zarte13/PI4/integration_elec/FOOTPRINTS/README.txt

Dossier pour mettre les footprints des pièces
