zarte13/PI4/integration_elec/SYMBOLS/README.txt

Dossier pour mettre les symboles des pièces spéciales
