zarte13/PI4/integration_elec/3D_PARTS/README.txt

Dossier pour mettre les modèles de pièces en 3D
