zarte13/PI4/integration_elec/3D_PARTS/SMA_DIO.step

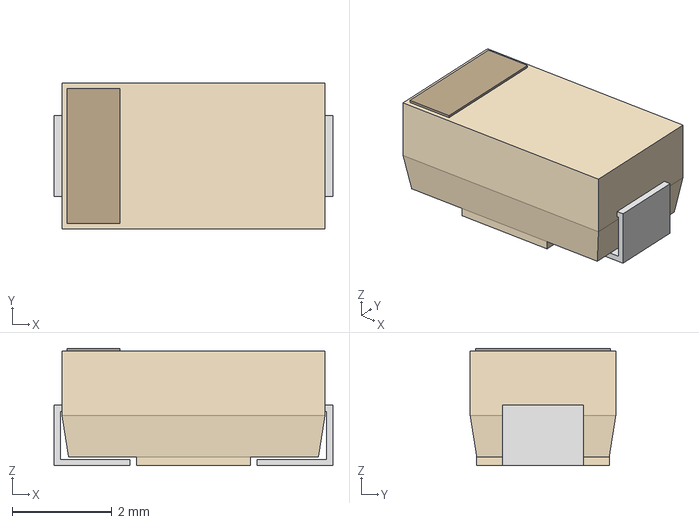
[picture p1: CAD file, 2026-02-20]
integration_elec/3D_PARTS/SMA_DIO.step
5.59 x 2.92 x 2.35 mm
