zarte13/PI4/integration_elec/3D_PARTS/RELAY8_J104D2C12VDC_20S_CRS.step

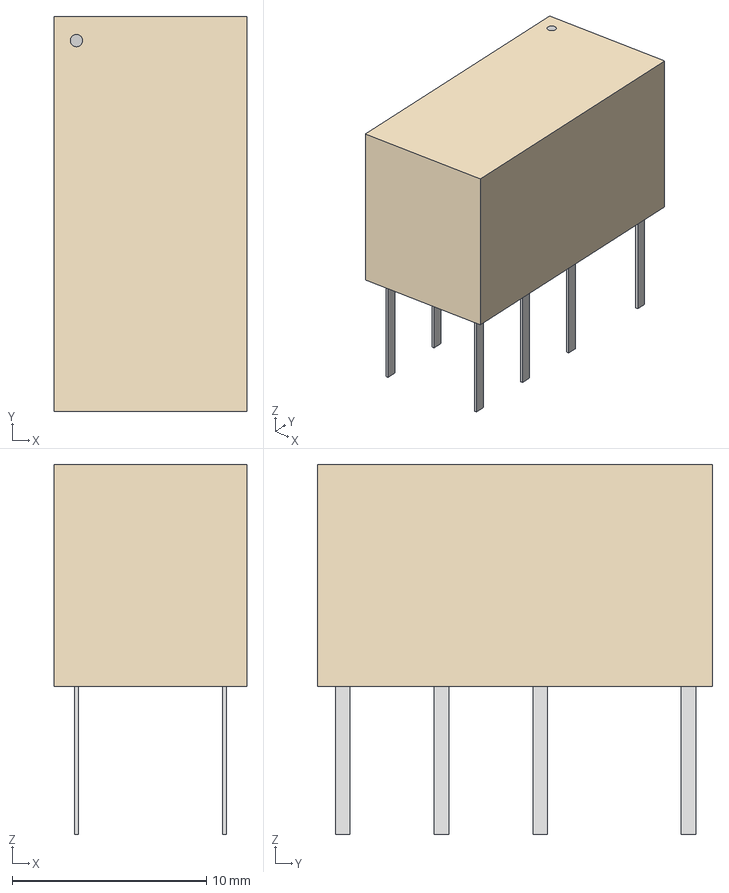
[picture p2: CAD file, 2026-02-20]
integration_elec/3D_PARTS/RELAY8_J104D2C12VDC_20S_CRS.step
9.91 x 20.3 x 19.1 mm
