zarte13/PI4/integration_elec/3D_PARTS/MICROFIT/436500315.stp

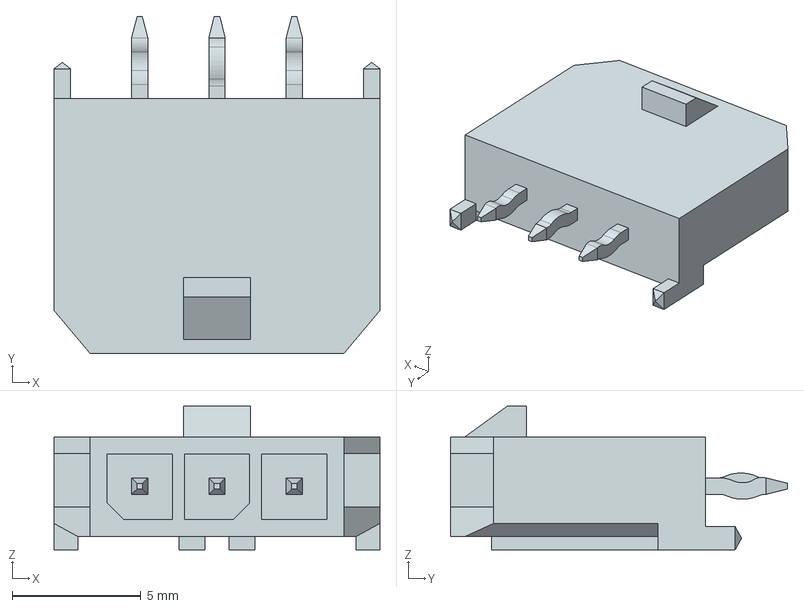
[picture p4: CAD file, 2026-03-10]
integration_elec/3D_PARTS/MICROFIT/436500315.stp
12.7 x 13.1 x 5.57 mm
