zarte13/PI4/(threads)

Thread 3 (2025-09-19):

Matrice decisionelle

zarte13, 2025-09-19:
Cette matrice permet de decider quelle sous-solution on choisit du type : pompe embarquee sur le drone, pompe au sol, deplacement d'air du type air comprimer paintball .....

Closed 2025-10-03.

Thread 11 (2025-09-21):

Analyse produit chimique préliminaire

zarte13, 2025-09-21:

zarte13, 2025-09-30:
**Funmilayo:**
- Recherche type de glace
- Contrainte environnementale des produits chimique (anti-givre)
- Corrosivité des produits
**Dominic:**
- Contrainte environnementale des produits chimiques (dégivrant)
-recherche composition structurelle éoliennes
-recherche solutions anti-givre (coatings)
-trouver le responsable des labos de projet indiv. de génie chimique et entrer en contact avec lui pour stocker montage expérimental
-envoyer fiches techniques produits chim. à Gino

Closed 2025-10-03.
