zarte13/PI4/integration_elec/integration_elec_slave/integration_elec_slave.kicad_pcb

## KiCad design integration_elec/integration_elec_slave/integration_elec_slave.kicad_pcb (2026-03-04)

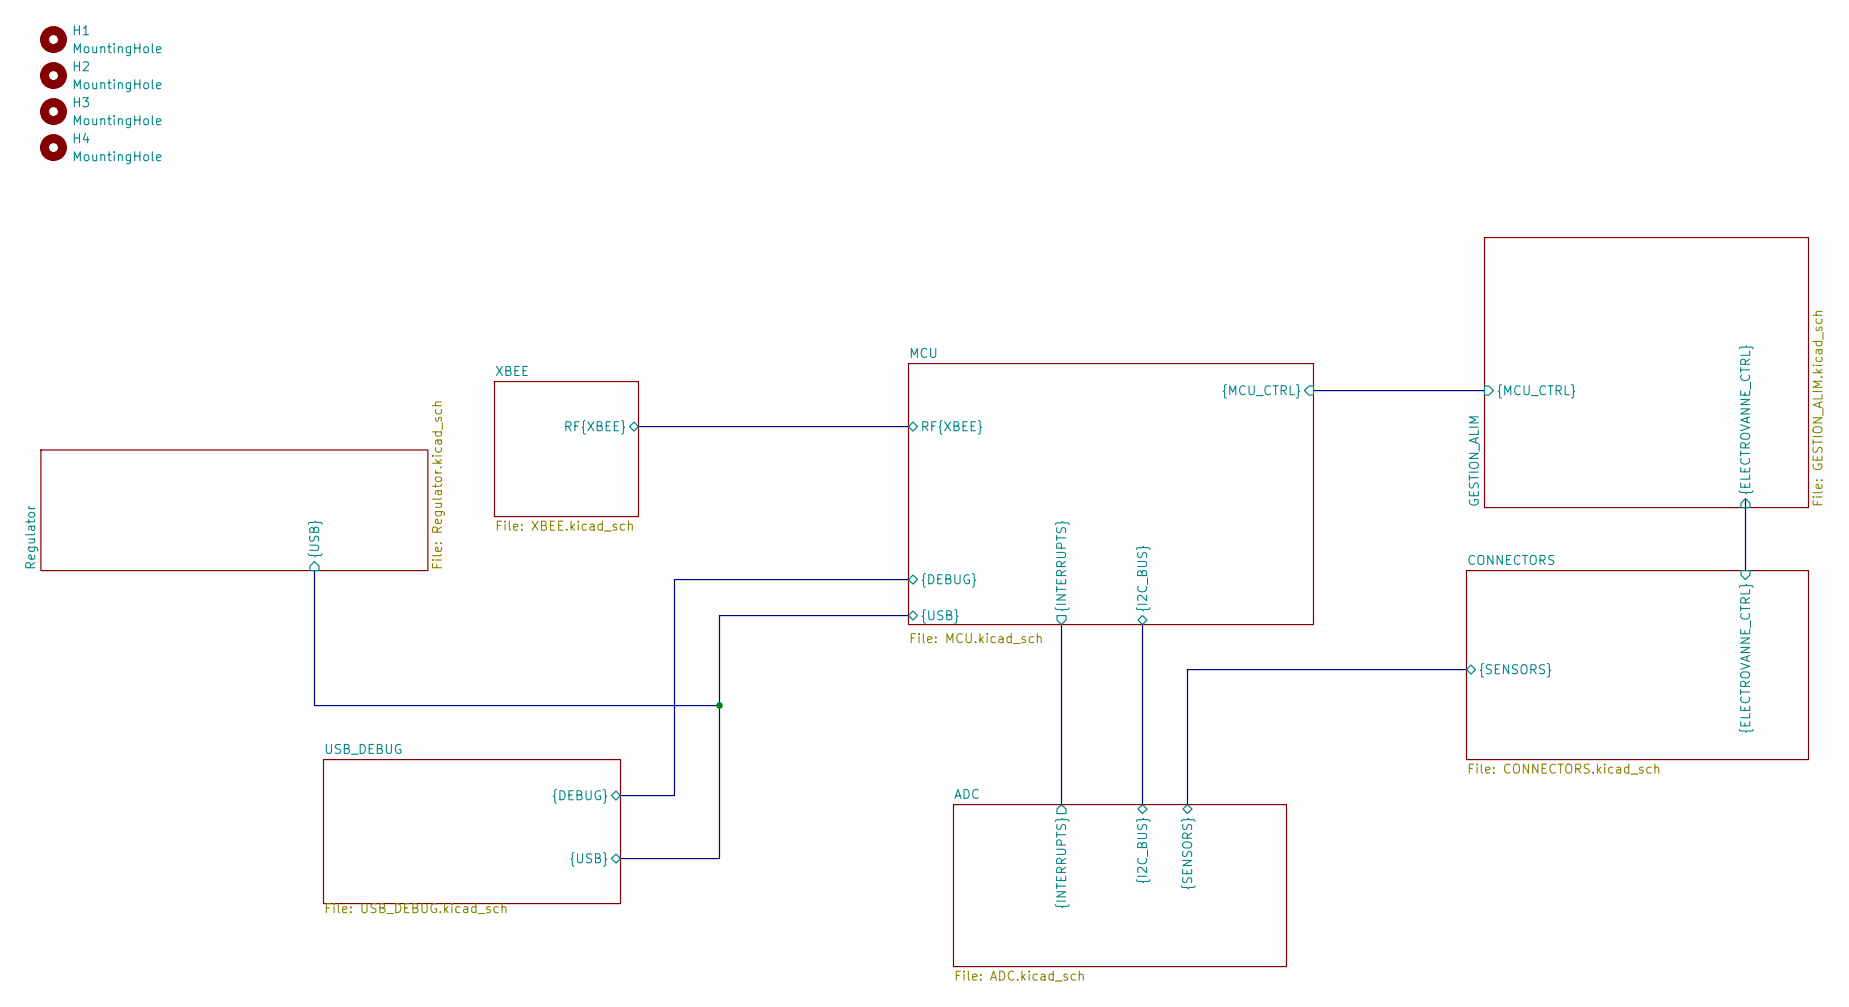
[picture p5: schematic integration_elec_slave.kicad_sch]

Parts:
H1, H2, H3, H4: MountingHole; MountingHole_3.2mm_M3

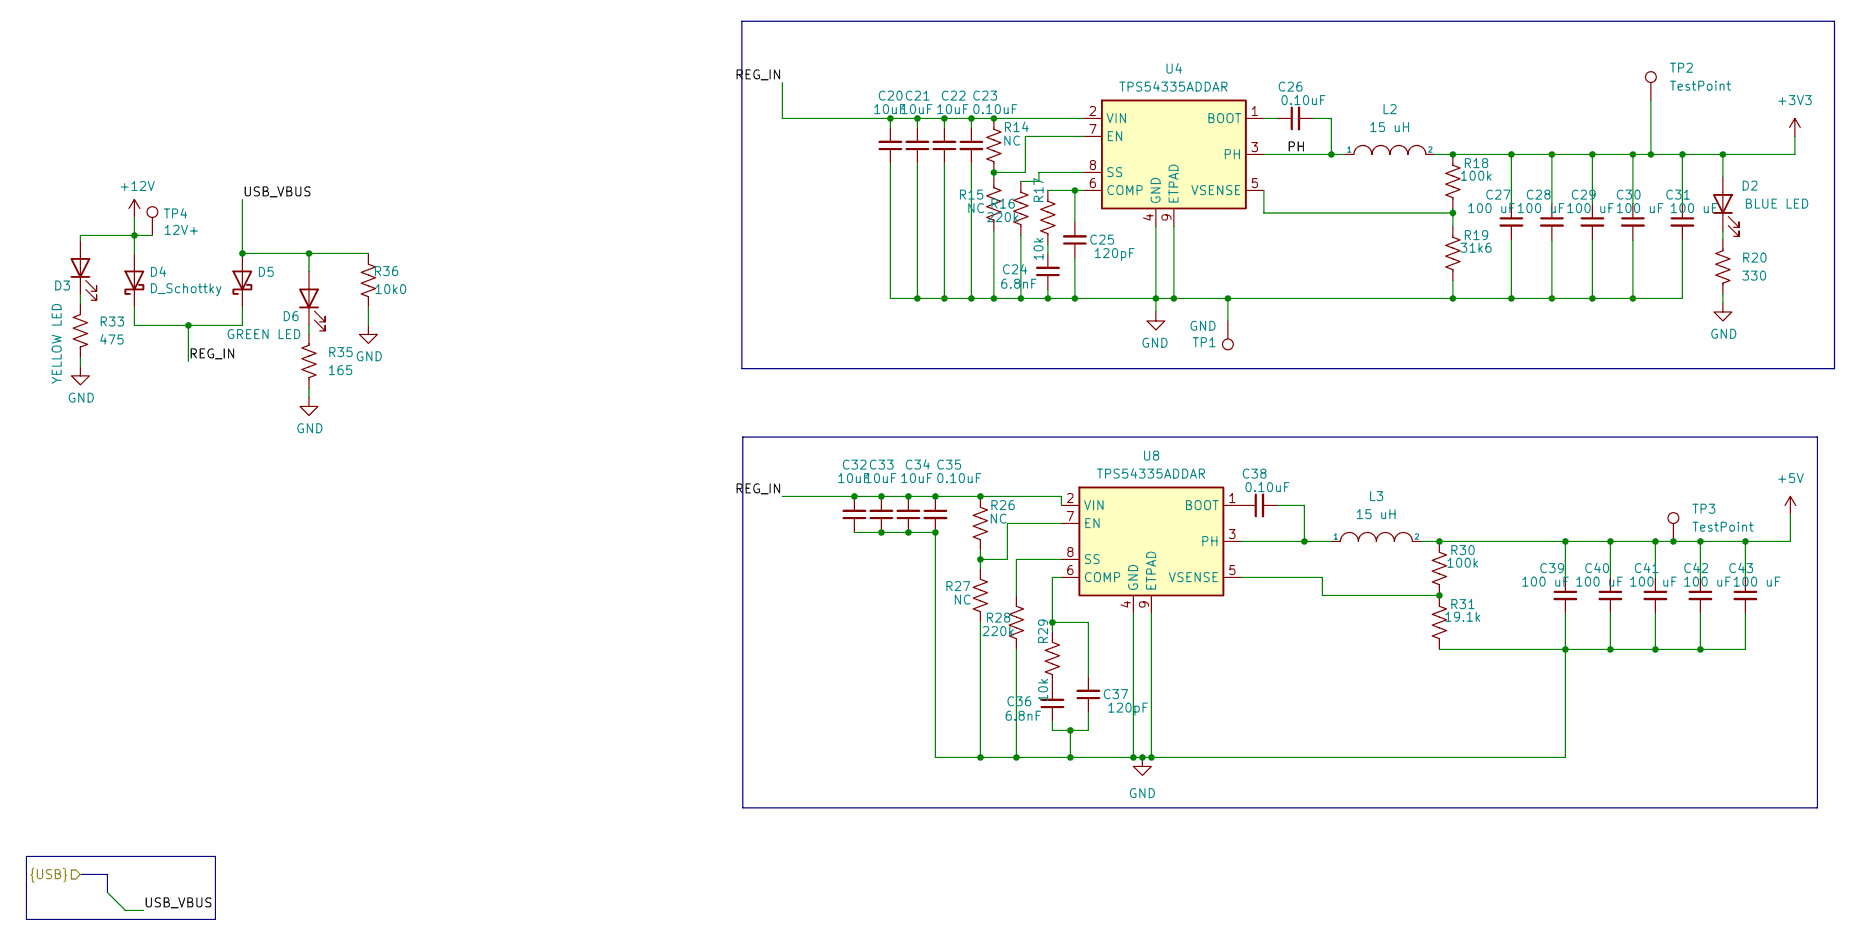
[picture p6: schematic Regulator.kicad_sch]

Parts:
C20, C21, C22, C32, C33, C34: 10uF; C_0805_2012Metric_Pad1.18x1.45mm_HandSolder; Manufacturer Part Number CL21A106KOQNNNE; DigiKey 1276-1096-1-ND
C23, C26, C35, C38: 0.10uF; C_0805_2012Metric_Pad1.18x1.45mm_HandSolder; Manufacturer Part Number CL21B104KBCNNNC; DigiKey 1276-1003-2-ND
C24, C36: 6.8nF; C_0805_2012Metric_Pad1.18x1.45mm_HandSolder; Manufacturer Part Number C0805C682K5RAC7800; DigiKey 399-C0805C682K5RAC7800TR-ND
C25, C37: 120pF; C_0805_2012Metric_Pad1.18x1.45mm_HandSolder; Manufacturer Part Number C0805C121J5GAC7800; DigiKey 399-C0805C121J5GAC7800TR-ND
C27, C28, C29, C30, C31, C39, C40, C41, C42, C43: 100 uF; C_1206_3216Metric; Manufacturer Part Number GRM31CR61A107MEA8L; DigiKey 490-GRM31CR61A107MEA8LTR-ND
D2: BLUE LED; LED_0805_2012Metric_Pad1.15x1.40mm_HandSolder; Manufacturer Part Number 5973605607F; DigiKey 350-4394-1-ND
D3: YELLOW LED; LED_1206_3216Metric; Manufacturer Part Number QTLP650D3TR; DigiKey 1080-1418-2-ND
D4, D5: D_Schottky; SOD323-HE; Manufacturer Part Number MBR1060HEWS_R1_00001; DigiKey 3757-MBR1060HEWS_R1_00001CT-ND
D6: GREEN LED; LED_1206_3216Metric; Manufacturer Part Number 5973605607F; DigiKey 350-4394-1-ND
L2, L3: 15 uH; IND_BOURNS_SRR1280; Manufacturer Part Number SRR1280-150M; DigiKey SRR1280-150MTR-ND
R14, R15, R26, R27: NC; R_0805_2012Metric_Pad1.20x1.40mm_HandSolder
R16, R28: 220k; R_0805_2012Metric_Pad1.20x1.40mm_HandSolder; Manufacturer Part Number CRG0805F220K; DigiKey A126350CT-ND
R17, R29: 10k; R_0805_2012Metric_Pad1.20x1.40mm_HandSolder; Manufacturer Part Number RC0805FR-0710KL; DigiKey 311-10.0KCRCT-ND
R18, R30: 100k; R_0805_2012Metric_Pad1.20x1.40mm_HandSolder; Manufacturer Part Number RC0805FR-07100KL; DigiKey 311-100KCRTR-ND
R19: 31k6; R_0805_2012Metric_Pad1.20x1.40mm_HandSolder; Manufacturer Part Number RC0805FR-0731K6L; DigiKey 311-31.6KCRTR-ND
R20: 330; R_0805_2012Metric_Pad1.20x1.40mm_HandSolder; Manufacturer Part Number RC0805JR-07330RL; DigiKey 311-330ARCT-ND
R31: 19.1k; R_0805_2012Metric_Pad1.20x1.40mm_HandSolder; DigiKey 311-19.1KCRCT-ND
R33: 475; R_0805_2012Metric_Pad1.20x1.40mm_HandSolder; Manufacturer Part Number RNCP0805FTD475R; DigiKey RNCP0805FTD475RTR-ND
R35: 165; R_0805_2012Metric_Pad1.20x1.40mm_HandSolder; Manufacturer Part Number RC0805FR-07165RL; DigiKey 311-165CRTR-ND
R36: 10k0; R_0603_1608Metric_Pad0.98x0.95mm_HandSolder; Manufacturer Part Number RC0805FR-0710KL; DigiKey 311-10.0KHRCT-ND
TP1: GND; TestPoint_Plated_Hole_D2.0mm
TP2, TP3: TestPoint; TestPoint_Plated_Hole_D2.0mm
TP4: 12V+; TestPoint_Plated_Hole_D2.0mm
U4, U8: TPS54335ADDAR; TI_SO-PowerPAD-8_ThermalVias; Manufacturer Part Number TPS54335ADDAR; DigiKey 296-TPS54335ADDARTR-ND

Connections:
+3V3: C27.1, C28.1, C29.1, C30.1, C31.1, D2.2 (A), L2.2, R18.1, TP2.1; also elsewhere on the board
+5V: C39.1, C40.1, C41.1, C42.1, C43.1, L3.2, R30.1, TP3.1; also elsewhere on the board
+12V: D3.2 (A), D4.2 (A), TP4.1; also elsewhere on the board
/MCU/USB_VBUS: D5.2 (A), D6.2 (A), R36.1; also elsewhere on the board
/Regulator/PH: C26.2, L2.1, U4.3 (PH)
/Regulator/REG_IN: C20.2, C21.2, C22.2, C23.1, C32.2, C33.2, C34.2, C35.1, D4.1 (K), D5.1 (K), R14.1, R26.1, U4.2 (VIN), U8.2 (VIN)
GND: C20.1, C21.1, C22.1, C23.2, C24.1, C25.1, C27.2, C28.2, C29.2, C30.2, C31.2, C32.1, C33.1, C34.1, C35.2, C36.1, C37.1, C39.2, C40.2, C41.2, C42.2, C43.2, R15.2, R16.2, R19.2, R20.2, R27.2, R28.2, R31.2, R33.2, R35.2, R36.2, TP1.1, U4.4 (GND), U4.9 (ETPAD), U8.4 (GND), U8.9 (ETPAD); also elsewhere on the board
unnamed: C24.2, R17.2
unnamed: C36.2, R29.2
unnamed: D2.1 (K), R20.1
unnamed: D3.1 (K), R33.1
unnamed: D6.1 (K), R35.1
unnamed: C26.1, U4.1 (BOOT)
unnamed: C25.2, R17.1, U4.6 (COMP)
unnamed: R14.2, R15.1, U4.7 (EN)
unnamed: R16.1, U4.8 (SS)
unnamed: R18.2, R19.1, U4.5 (VSENSE)
unnamed: C38.1, U8.1 (BOOT)
unnamed: C37.2, R29.1, U8.6 (COMP)
unnamed: R26.2, R27.1, U8.7 (EN)
unnamed: C38.2, L3.1, U8.3 (PH)
unnamed: R28.1, U8.8 (SS)
unnamed: R30.2, R31.1, U8.5 (VSENSE)

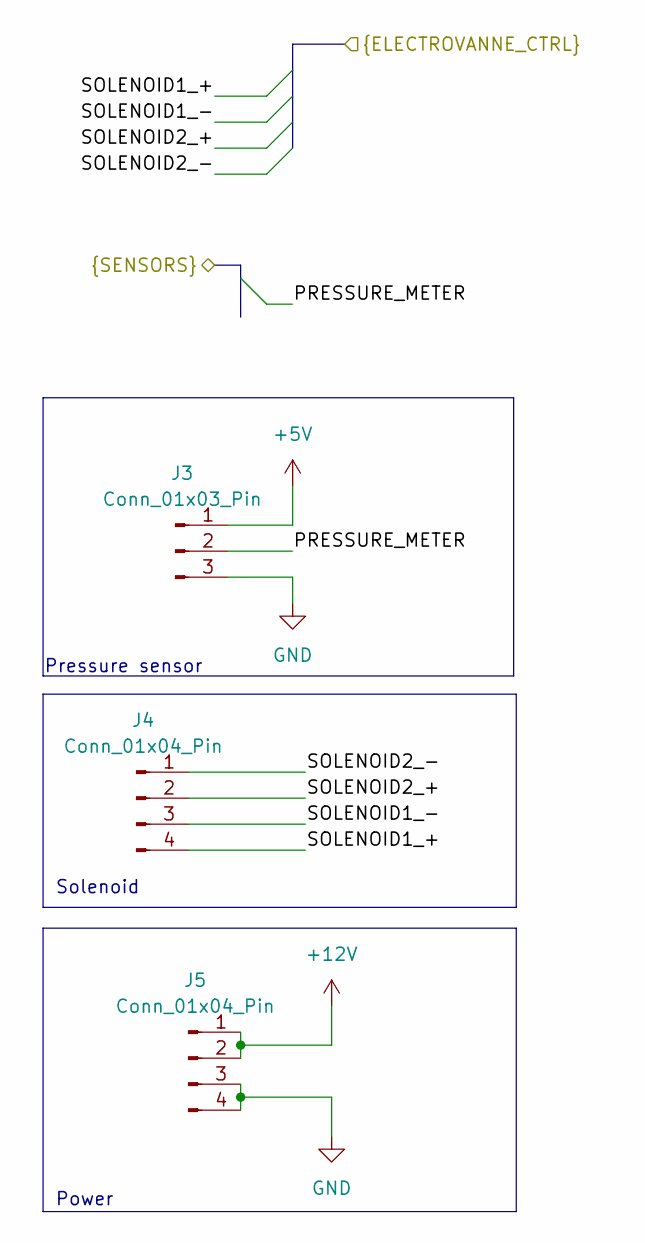
[picture p7: schematic CONNECTORS.kicad_sch]

Parts:
J3: Conn_01x03_Pin; Molex_Micro-Fit_3.0_43650-0315_1x03_P3.00mm_Vertical; DigiKey 538-43650-0315
J4, J5: Conn_01x04_Pin; Molex_Micro-Fit_3.0_43650-0415_1x04_P3.00mm_Vertical; DigiKey WM1919-ND

Connections:
+5V: J3.1; also elsewhere on the board
+12V: J5.1, J5.2; also elsewhere on the board
/ADC/PRESSURE_METER: J3.2; also elsewhere on the board
/CONNECTORS/SOLENOID1_+: J4.4; also elsewhere on the board
/CONNECTORS/SOLENOID1_-: J4.3; also elsewhere on the board
/CONNECTORS/SOLENOID2_+: J4.2; also elsewhere on the board
/CONNECTORS/SOLENOID2_-: J4.1; also elsewhere on the board
GND: J3.3, J5.3, J5.4; also elsewhere on the board

Notes on the sheet:
Pressure sensor
Power
Solenoid

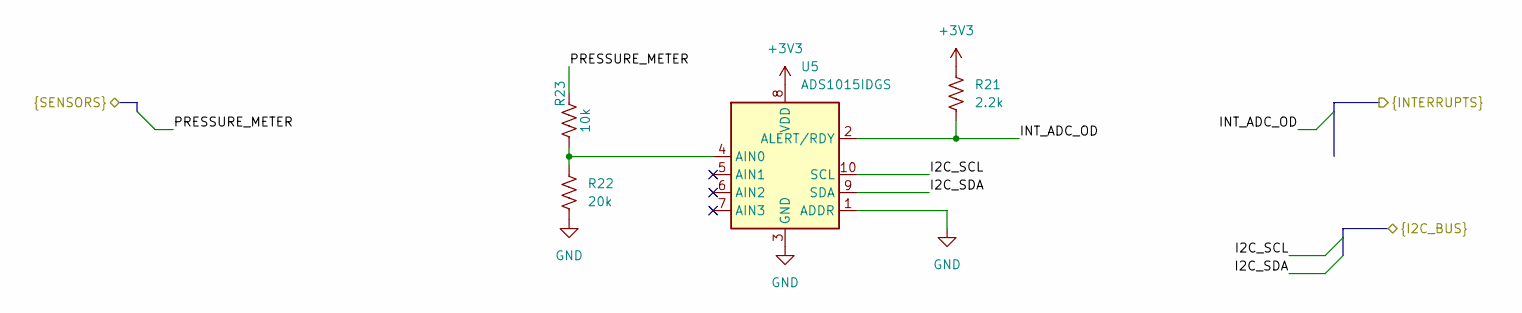
[picture p8: schematic ADC.kicad_sch]

Parts:
R21: 2.2k; R_0805_2012Metric_Pad1.20x1.40mm_HandSolder; DigiKey 311-2.20KCRCT-ND
R22: 20k; R_0805_2012Metric_Pad1.20x1.40mm_HandSolder; DigiKey P20KDACT-ND
R23: 10k; R_0805_2012Metric_Pad1.20x1.40mm_HandSolder; Manufacturer Part Number RC0805FR-0710KL; DigiKey 311-10.0KCRCT-ND
U5: ADS1015IDGS; TSSOP-10_3x3mm_P0.5mm; DigiKey 595-ADS1015IDGSR

Connections:
+3V3: R21.1, U5.8 (VDD); also elsewhere on the board
/ADC/I2C_SCL: U5.10 (SCL); also elsewhere on the board
/ADC/I2C_SDA: U5.9 (SDA); also elsewhere on the board
/ADC/INT_ADC_OD: R21.2, U5.2 (ALERT/RDY); also elsewhere on the board
/ADC/PRESSURE_METER: R23.1; also elsewhere on the board
GND: R22.2, U5.1 (ADDR), U5.3 (GND); also elsewhere on the board
unnamed: R22.1, R23.2, U5.4 (AIN0)

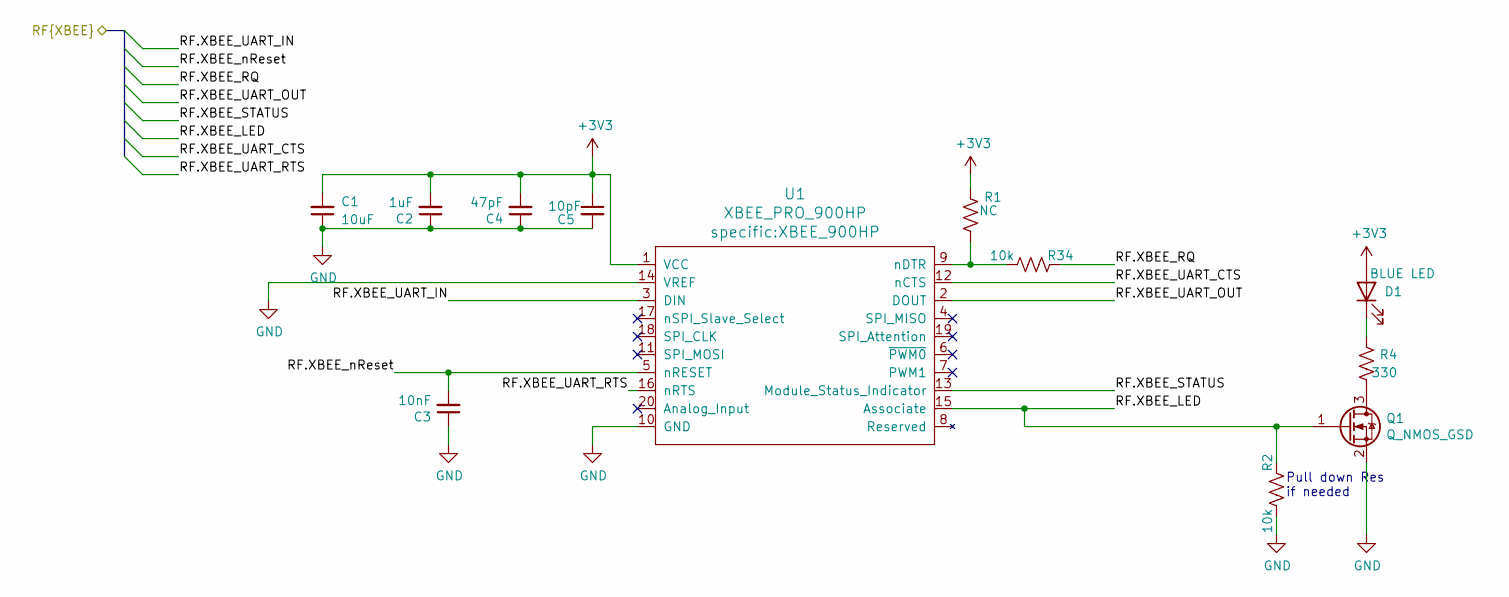
[picture p9: schematic XBEE.kicad_sch]

Parts:
C1: 10uF; C_0805_2012Metric_Pad1.18x1.45mm_HandSolder; Manufacturer Part Number CL21A106KOQNNNE; DigiKey 1276-1096-1-ND
C2: 1uF; C_0805_2012Metric_Pad1.18x1.45mm_HandSolder; Manufacturer Part Number C0805C105K4RAC7800; DigiKey 399-C0805C105K4RAC7800TR-ND
C3: 10nF; C_0805_2012Metric_Pad1.18x1.45mm_HandSolder; Manufacturer Part Number CL21B103KBANNNC; DigiKey 1276-1015-1-ND
C4: 47pF; C_0805_2012Metric_Pad1.18x1.45mm_HandSolder; Manufacturer Part Number C0805C470J5GAC7210; DigiKey 399-C0805C470J5GAC7210TR-ND
C5: 10pF; C_0805_2012Metric_Pad1.18x1.45mm_HandSolder; Manufacturer Part Number C0805C100J5GAC7800; DigiKey 399-C0805C100J5GAC7800TR-ND
D1: BLUE LED; LED_0805_2012Metric_Pad1.15x1.40mm_HandSolder; Manufacturer Part Number 5973605607F; DigiKey 350-4394-1-ND
Q1: Q_NMOS_GSD; SOT-23; Manufacturer Part Number 2N7002-TP; DigiKey 2N7002-TPMSCT-ND
R1: NC; R_0805_2012Metric_Pad1.20x1.40mm_HandSolder
R2, R34: 10k; R_0805_2012Metric_Pad1.20x1.40mm_HandSolder; Manufacturer Part Number RC0805FR-0710KL; DigiKey 311-10.0KCRCT-ND
R4: 330; R_0805_2012Metric_Pad1.20x1.40mm_HandSolder; Manufacturer Part Number RC0805JR-07330RL; DigiKey 311-330ARCT-ND
U1: XBEE_PRO_900HP; XBEE_900HP; Manufacturer Part Number XBP9B-DMST-002; DigiKey 602-1299-ND

Connections:
+3V3: C1.2, C2.2, C4.2, C5.1, D1.2 (A), R1.1, U1.1 (VCC); also elsewhere on the board
/MCU/RF.XBEE_LED: Q1.1 (G), R2.1, U1.15 (Associate); also elsewhere on the board
/MCU/RF.XBEE_RQ: R34.1; also elsewhere on the board
/MCU/RF.XBEE_STATUS: U1.13 (Module_Status_Indicator); also elsewhere on the board
/MCU/RF.XBEE_UART_CTS: U1.12 (nCTS); also elsewhere on the board
/MCU/RF.XBEE_UART_IN: U1.3 (DIN); also elsewhere on the board
/MCU/RF.XBEE_UART_OUT: U1.2 (DOUT); also elsewhere on the board
/MCU/RF.XBEE_UART_RTS: U1.16 (nRTS); also elsewhere on the board
/MCU/RF.XBEE_nReset: C3.2, U1.5 (nRESET); also elsewhere on the board
GND: C1.1, C2.1, C3.1, C4.1, C5.2, Q1.2 (S), R2.2, U1.10 (GND), U1.14 (VREF); also elsewhere on the board
unnamed: D1.1 (K), R4.1
unnamed: Q1.3 (D), R4.2
unnamed: R1.2, R34.2, U1.9 (nDTR)

Notes on the sheet:
Pull down Res if needed

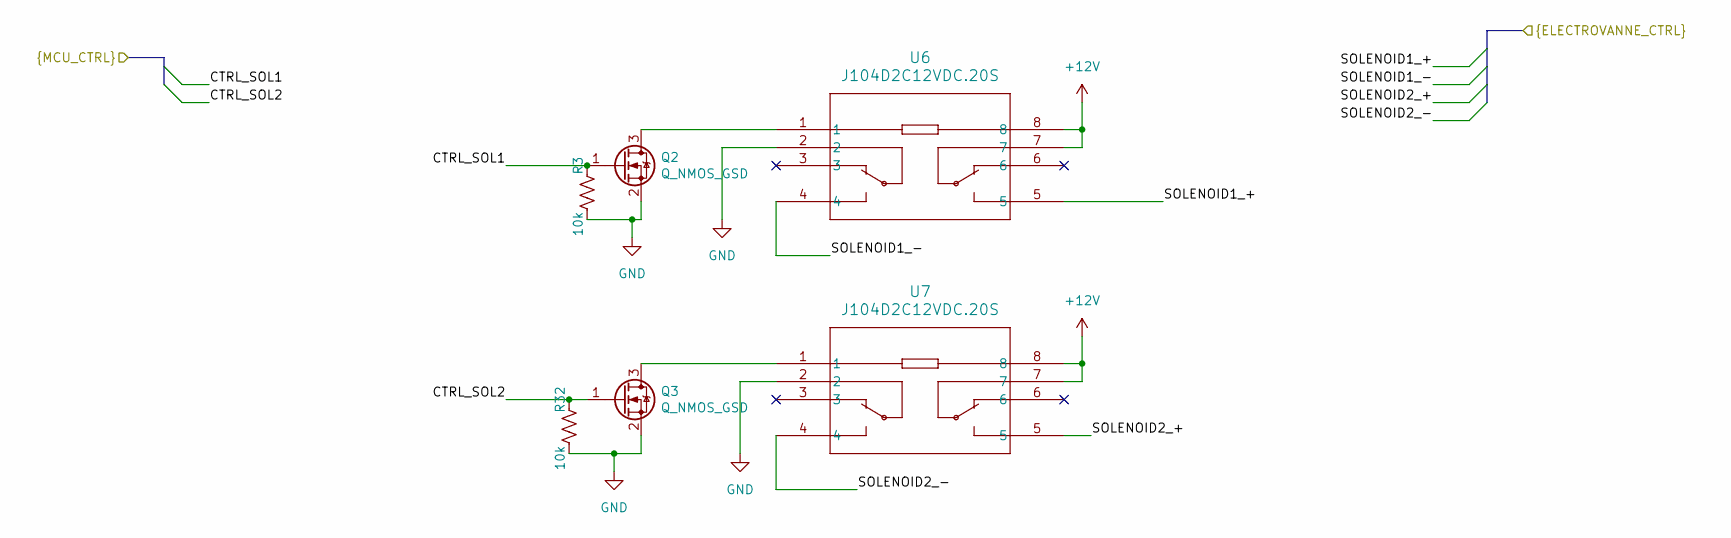
[picture p10: schematic GESTION_ALIM.kicad_sch]

Parts:
Q2, Q3: Q_NMOS_GSD; SOT-23; Manufacturer Part Number SQ2308CES-T1_GE3; DigiKey SQ2308CES-T1_GE3CT-ND
R3, R32: 10k; R_0805_2012Metric_Pad1.20x1.40mm_HandSolder; Manufacturer Part Number RC0805FR-0710KL; DigiKey 311-10.0KCRCT-ND
U6, U7: J104D2C12VDC.20S; RELAY8_J104D2C12VDC.20S_CRS; DigiKey 2449-J104D2C12VDC.20S-ND

Connections:
+12V: U6.7, U6.8, U7.7, U7.8; also elsewhere on the board
/CONNECTORS/SOLENOID1_+: U6.5; also elsewhere on the board
/CONNECTORS/SOLENOID1_-: U6.4; also elsewhere on the board
/CONNECTORS/SOLENOID2_+: U7.5; also elsewhere on the board
/CONNECTORS/SOLENOID2_-: U7.4; also elsewhere on the board
/GESTION_ALIM/CTRL_SOL1: Q2.1 (G), R3.1; also elsewhere on the board
/GESTION_ALIM/CTRL_SOL2: Q3.1 (G), R32.1; also elsewhere on the board
GND: Q2.2 (S), Q3.2 (S), R3.2, R32.2, U6.2, U7.2; also elsewhere on the board
unnamed: Q2.3 (D), U6.1
unnamed: Q3.3 (D), U7.1

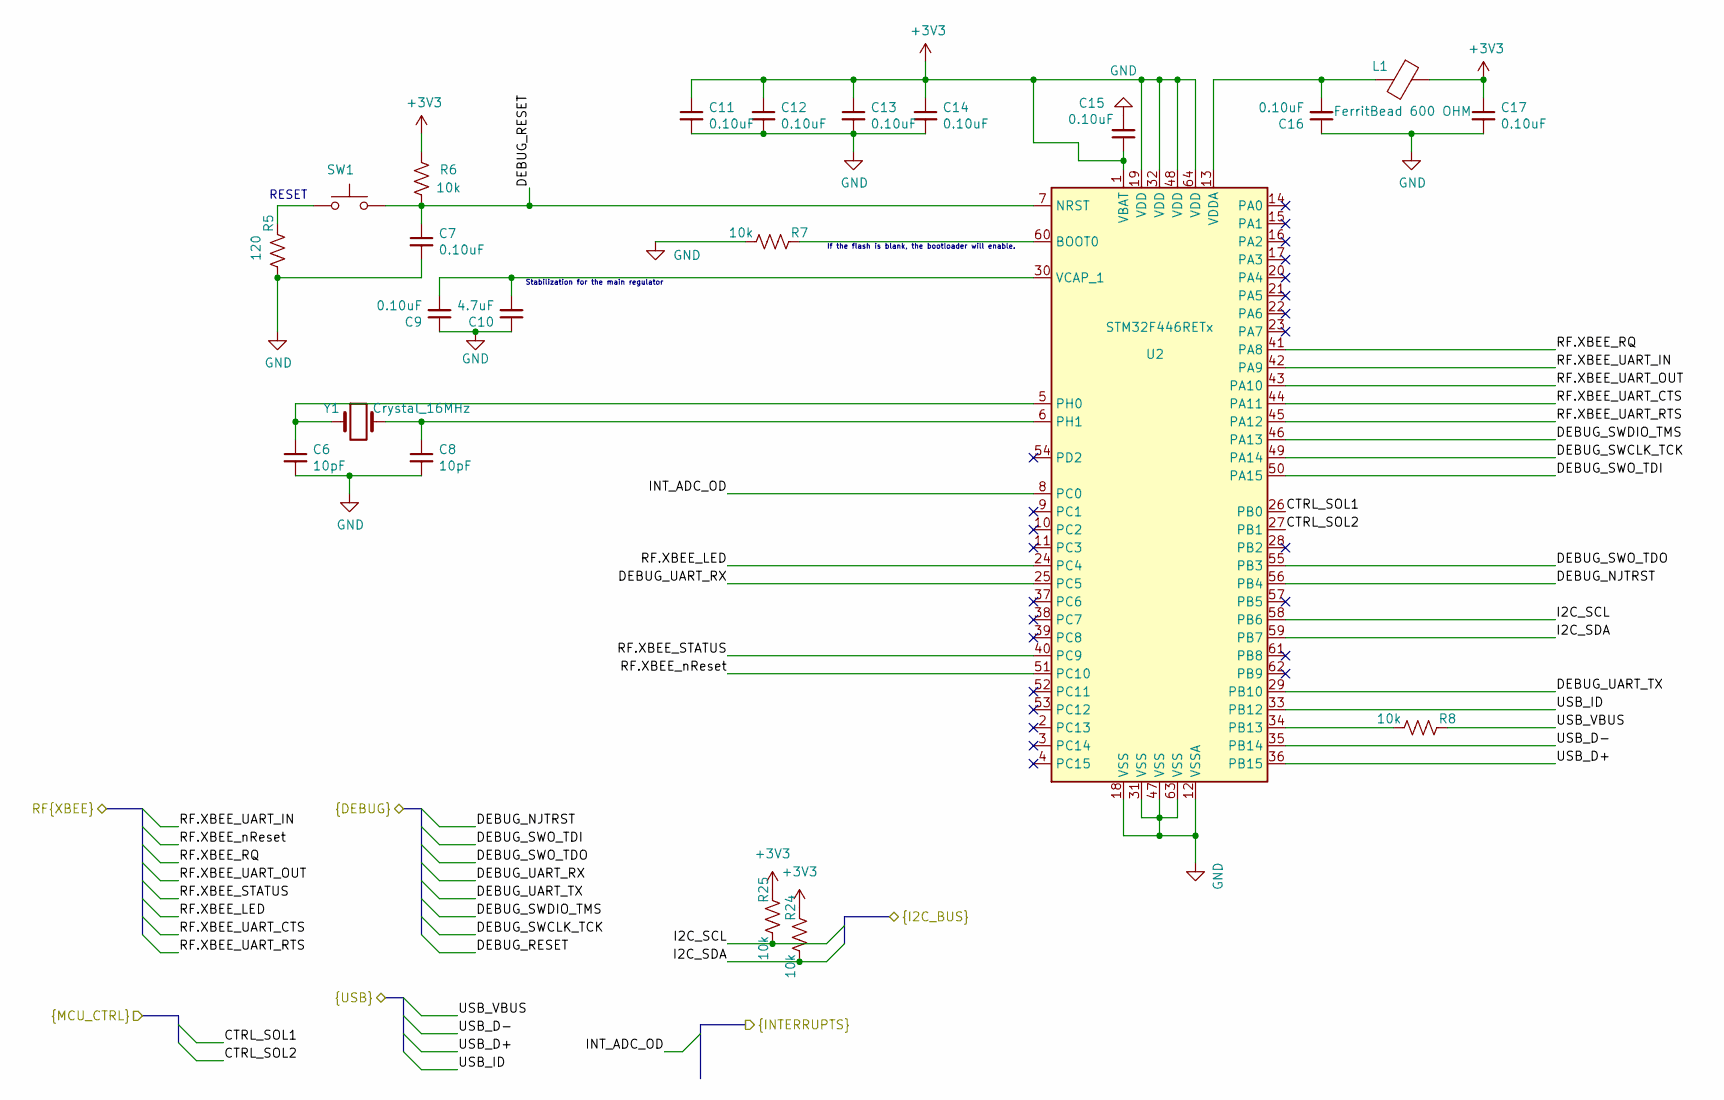
[picture p11: schematic MCU.kicad_sch]

Parts:
C6, C8: 10pF; C_0805_2012Metric_Pad1.18x1.45mm_HandSolder; Manufacturer Part Number C0805C100J5GAC7800; DigiKey 399-C0805C100J5GAC7800TR-ND
C7, C9, C11, C12, C13, C14, C15, C16, C17: 0.10uF; C_0805_2012Metric_Pad1.18x1.45mm_HandSolder; Manufacturer Part Number CL21B104KBCNNNC; DigiKey 1276-1003-2-ND
C10: 4.7uF; C_0805_2012Metric_Pad1.18x1.45mm_HandSolder; Manufacturer Part Number CL21A475KOFNNNE; DigiKey 1276-1065-1-ND
L1: FerritBead 600 OHM; L_0805_2012Metric_Pad1.15x1.40mm_HandSolder; Manufacturer Part Number 742792040; DigiKey 732-1620-1-ND
R5: 120; R_0805_2012Metric_Pad1.20x1.40mm_HandSolder; Manufacturer Part Number RC0805JR-07120RL; DigiKey 311-120ARCT-ND
R6, R7, R8, R24, R25: 10k; R_0805_2012Metric_Pad1.20x1.40mm_HandSolder; Manufacturer Part Number RC0805FR-0710KL; DigiKey 311-10.0KCRCT-ND
SW1: SW_Push; SW_SPST_TL3342; Manufacturer Part Number TL3342F160QG/TR; DigiKey EG2531CT-ND
U2: STM32F446RETx; LQFP-64_10x10mm_P0.5mm; Manufacturer Part Number STM32F446RET6; DigiKey 497-15376-ND
Y1: Crystal_16MHz; CSM-3X; Manufacturer Part Number ECS-160-20-3X-TR; DigiKey XC1776CT-ND

Connections:
+3V3: C11.1, C12.1, C13.1, C14.1, C15.1, C17.1, L1.1, R6.1, R24.1, R25.1, U2.1 (VBAT), U2.19 (VDD), U2.32 (VDD), U2.48 (VDD), U2.64 (VDD); also elsewhere on the board
/ADC/I2C_SCL: R25.2, U2.58 (PB6); also elsewhere on the board
/ADC/I2C_SDA: R24.2, U2.59 (PB7); also elsewhere on the board
/ADC/INT_ADC_OD: U2.8 (PC0); also elsewhere on the board
/GESTION_ALIM/CTRL_SOL1: U2.26 (PB0); also elsewhere on the board
/GESTION_ALIM/CTRL_SOL2: U2.27 (PB1); also elsewhere on the board
/MCU/DEBUG_NJTRST: U2.56 (PB4); also elsewhere on the board
/MCU/DEBUG_RESET: C7.1, R6.2, SW1.2, U2.7 (NRST); also elsewhere on the board
/MCU/DEBUG_SWCLK_TCK: U2.49 (PA14); also elsewhere on the board
/MCU/DEBUG_SWDIO_TMS: U2.46 (PA13); also elsewhere on the board
/MCU/DEBUG_SWO_TDI: U2.50 (PA15); also elsewhere on the board
/MCU/DEBUG_SWO_TDO: U2.55 (PB3); also elsewhere on the board
/MCU/DEBUG_UART_RX: U2.25 (PC5); also elsewhere on the board
/MCU/DEBUG_UART_TX: U2.29 (PB10); also elsewhere on the board
/MCU/RF.XBEE_LED: U2.24 (PC4); also elsewhere on the board
/MCU/RF.XBEE_RQ: U2.41 (PA8); also elsewhere on the board
/MCU/RF.XBEE_STATUS: U2.40 (PC9); also elsewhere on the board
/MCU/RF.XBEE_UART_CTS: U2.44 (PA11); also elsewhere on the board
/MCU/RF.XBEE_UART_IN: U2.42 (PA9); also elsewhere on the board
/MCU/RF.XBEE_UART_OUT: U2.43 (PA10); also elsewhere on the board
/MCU/RF.XBEE_UART_RTS: U2.45 (PA12); also elsewhere on the board
/MCU/RF.XBEE_nReset: U2.51 (PC10); also elsewhere on the board
/MCU/USB_D+: U2.36 (PB15); also elsewhere on the board
/MCU/USB_D-: U2.35 (PB14); also elsewhere on the board
/MCU/USB_ID: U2.33 (PB12)
/MCU/USB_VBUS: R8.1; also elsewhere on the board
GND: C6.2, C7.2, C8.2, C9.1, C10.1, C11.2, C12.2, C13.2, C14.2, C15.2, C16.1, C17.2, R5.2, R7.2, U2.12 (VSSA), U2.18 (VSS), U2.31 (VSS), U2.47 (VSS), U2.63 (VSS); also elsewhere on the board
unnamed: R5.1, SW1.1
unnamed: R7.1, U2.60 (BOOT0)
unnamed: R8.2, U2.34 (PB13)
unnamed: C6.1, U2.5 (PH0), Y1.1
unnamed: C8.1, U2.6 (PH1), Y1.2
unnamed: C9.2, C10.2, U2.30 (VCAP_1)
unnamed: C16.2, L1.2, U2.13 (VDDA)

Notes on the sheet:
RESET
If the flash is blank, the bootloader will enable.
Stabilization for the main regulator

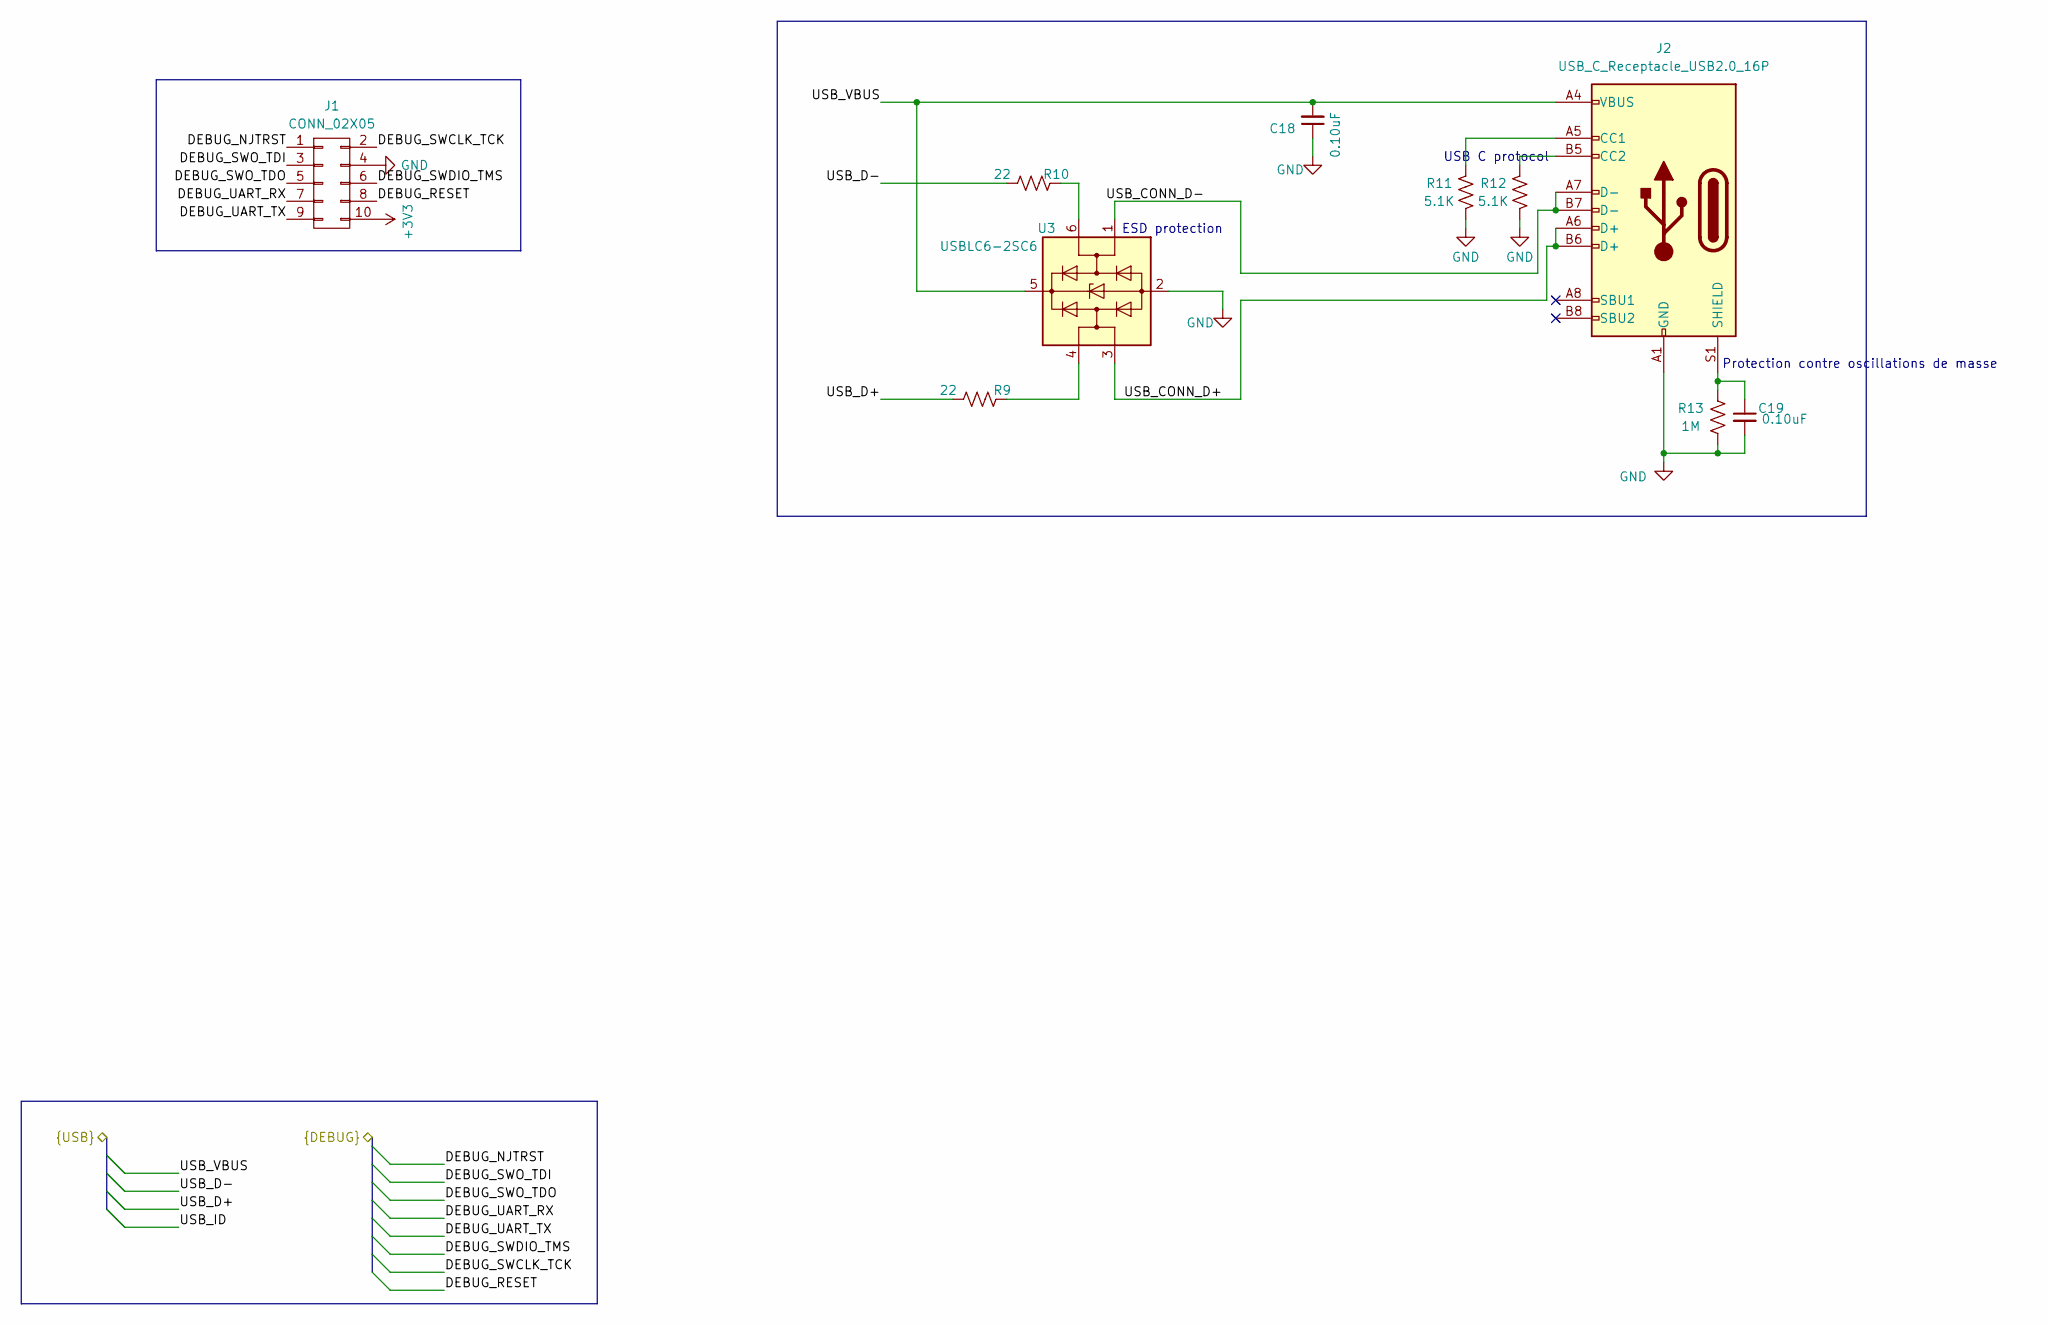
[picture p12: schematic USB_DEBUG.kicad_sch]

Parts:
C18, C19: 0.10uF; C_0805_2012Metric_Pad1.18x1.45mm_HandSolder; Manufacturer Part Number CL21B104KBCNNNC; DigiKey 1276-1003-2-ND
J1: CONN_02X05; CONN_CNC_10_pins; DigiKey 1175-1627-ND
J2: USB_C_Receptacle_USB2.0_16P; USB_C_Receptacle_GCT_USB4105-xx-A_16P_TopMnt_Horizontal; DigiKey 2073-USB4105-GF-ACT-ND
R9, R10: 22; R_0805_2012Metric_Pad1.20x1.40mm_HandSolder; Manufacturer Part Number RC0805JR-0722RL; DigiKey 311-22ARCT-ND
R11, R12: 5.1K; R_0603_1608Metric_Pad0.98x0.95mm_HandSolder; DigiKey 311-5.10KHRCT-ND
R13: 1M; R_0805_2012Metric_Pad1.20x1.40mm_HandSolder; Manufacturer Part Number RC0805FR-071ML; DigiKey 311-1.00MCRTR-ND
U3: USBLC6-2SC6; SOT-23-6; Manufacturer Part Number USBLC6-2SC6Y; DigiKey 497-11882-1-ND

Connections:
+3V3: J1.10; also elsewhere on the board
/MCU/DEBUG_NJTRST: J1.1; also elsewhere on the board
/MCU/DEBUG_RESET: J1.8; also elsewhere on the board
/MCU/DEBUG_SWCLK_TCK: J1.2; also elsewhere on the board
/MCU/DEBUG_SWDIO_TMS: J1.6; also elsewhere on the board
/MCU/DEBUG_SWO_TDI: J1.3; also elsewhere on the board
/MCU/DEBUG_SWO_TDO: J1.5; also elsewhere on the board
/MCU/DEBUG_UART_RX: J1.7; also elsewhere on the board
/MCU/DEBUG_UART_TX: J1.9; also elsewhere on the board
/MCU/USB_D+: R9.2; also elsewhere on the board
/MCU/USB_D-: R10.2; also elsewhere on the board
/MCU/USB_VBUS: C18.2, J2.A4 (VBUS), J2.A9 (VBUS), J2.B4 (VBUS), J2.B9 (VBUS), U3.5 (VBUS); also elsewhere on the board
/USB_DEBUG/USB_CONN_D+: J2.A6 (D+), J2.B6 (D+), U3.3 (I/O2)
/USB_DEBUG/USB_CONN_D-: J2.A7 (D-), J2.B7 (D-), U3.1 (I/O1)
GND: C18.1, C19.2, J1.4, J2.A1 (GND), J2.A12 (GND), J2.B1 (GND), J2.B12 (GND), R11.2, R12.2, R13.1, U3.2 (GND); also elsewhere on the board
unnamed: J2.A5 (CC1), R11.1
unnamed: J2.B5 (CC2), R12.1
unnamed: C19.1, J2.S1 (SHIELD), R13.2
unnamed: R9.1, U3.4 (I/O2)
unnamed: R10.1, U3.6 (I/O1)

Notes on the sheet:
USB C protocol
ESD protection
Protection contre oscillations de masse
