zarte13/PI4/integration_elec/integration_elec_slave/integration_elec_slave.kicad_pcb

## KiCad design integration_elec/integration_elec_slave/integration_elec_slave.kicad_pcb (continued)

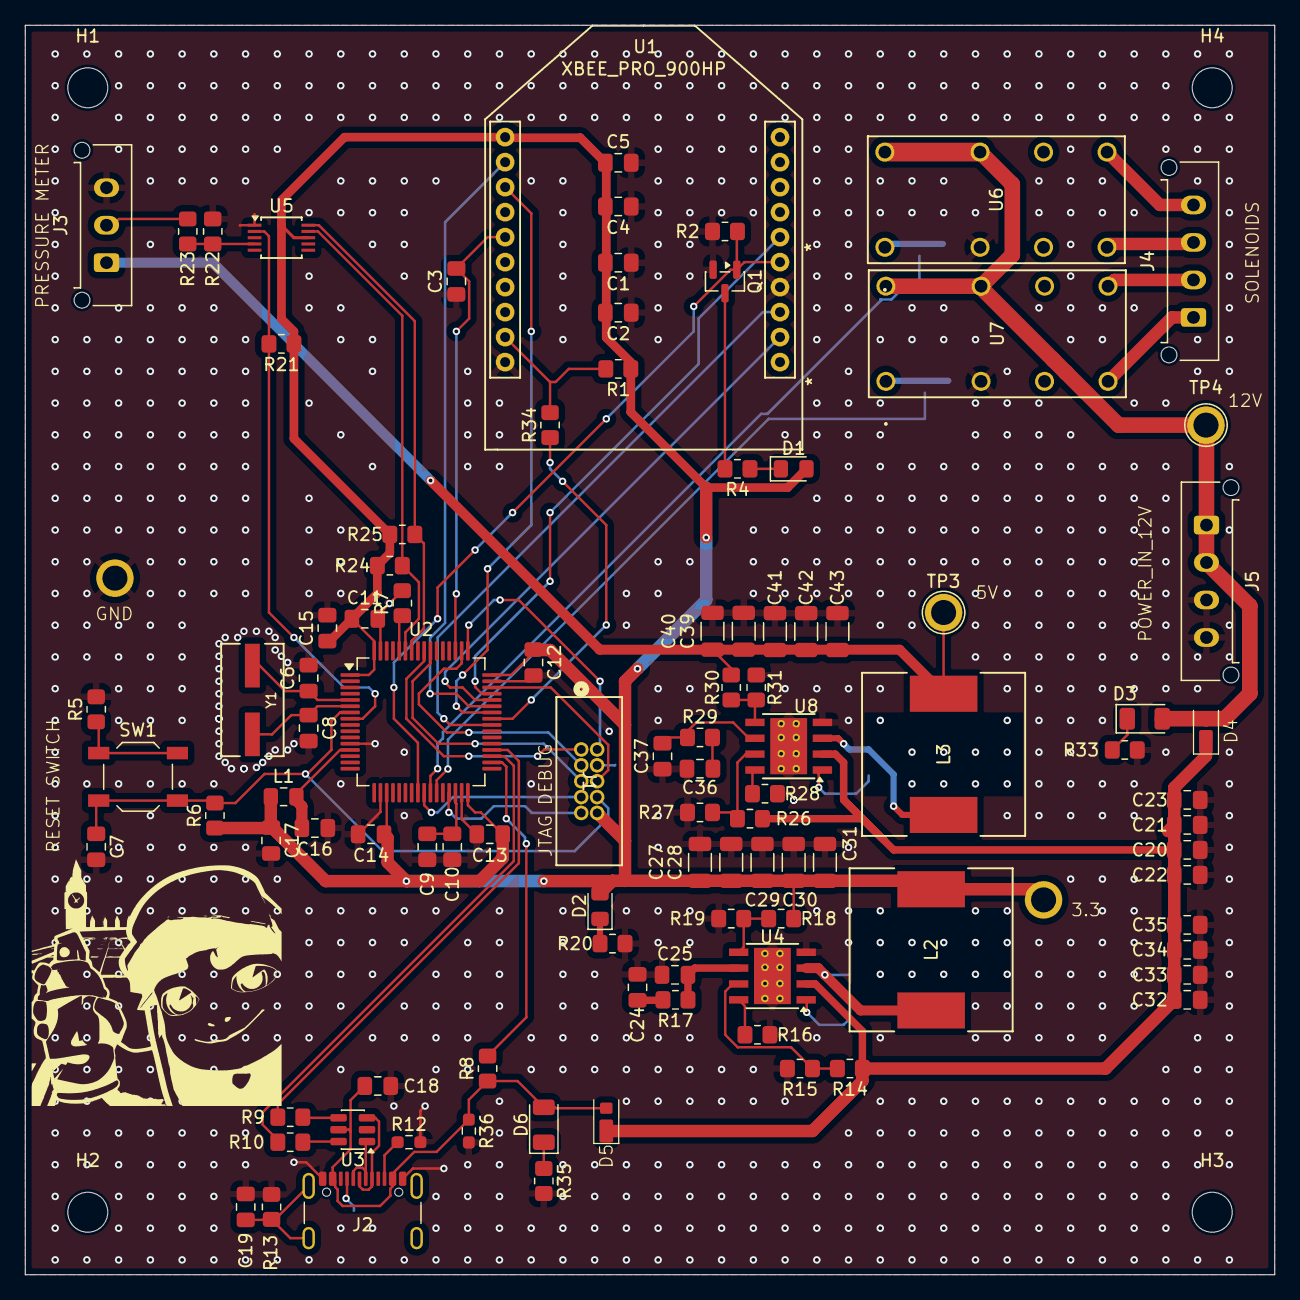
[picture p13: board integration_elec_slave.kicad_pcb from above]

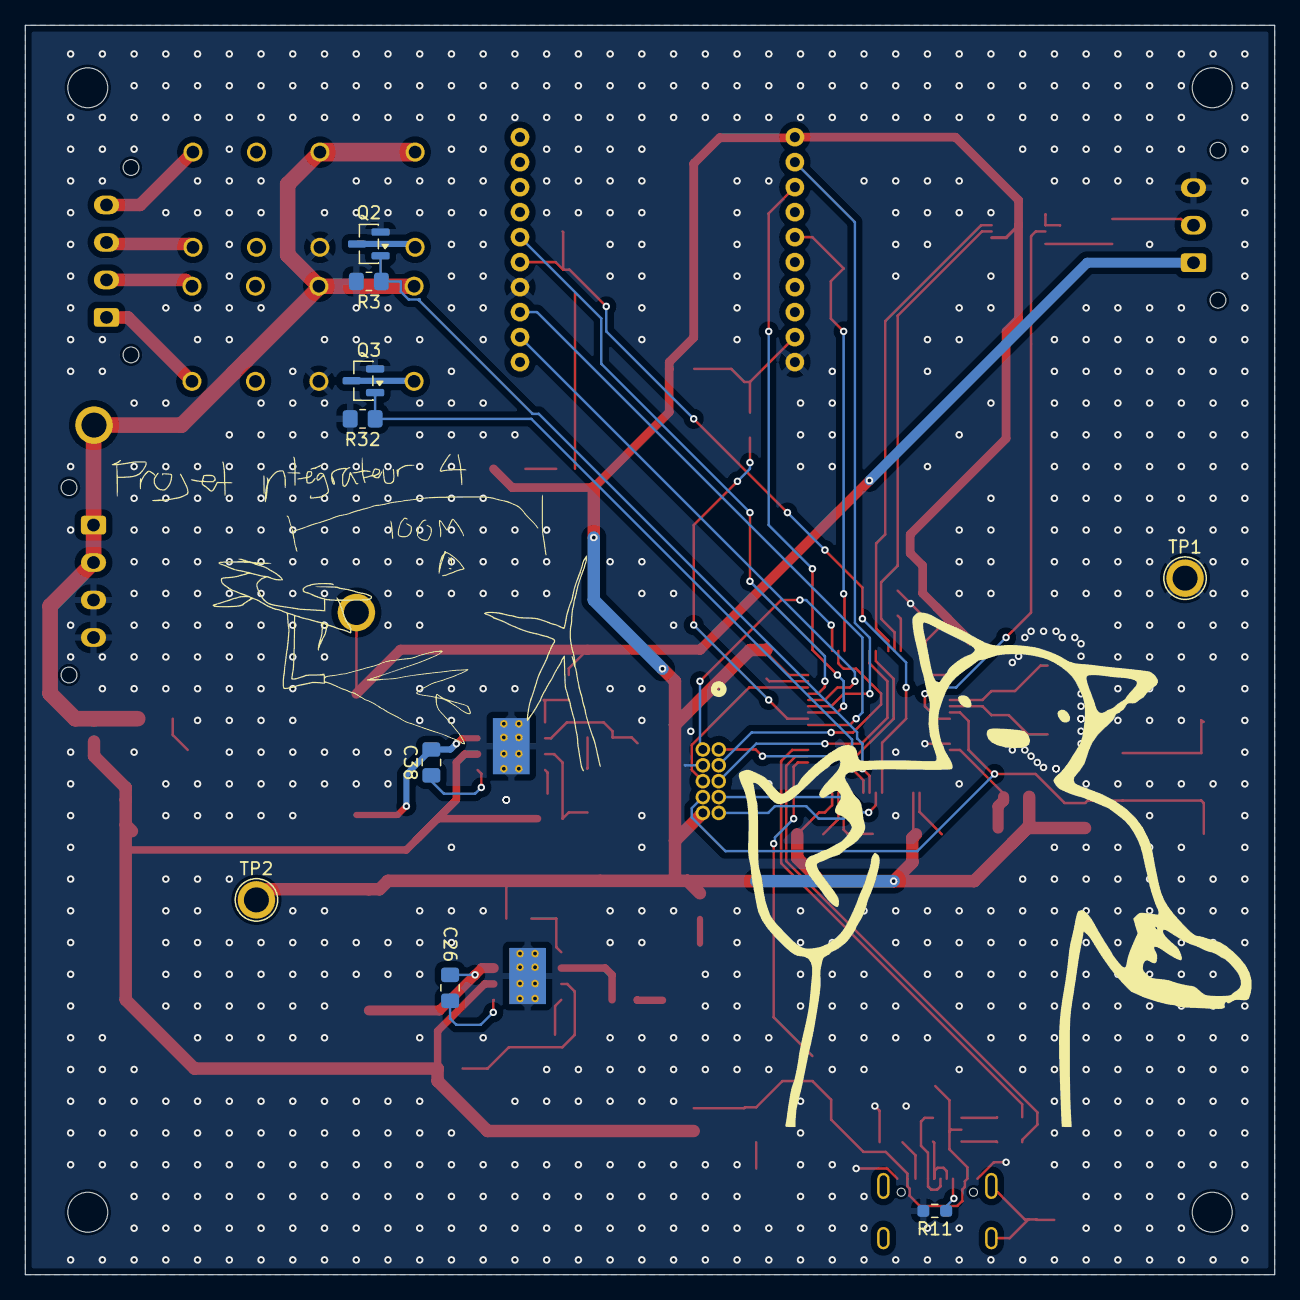
[picture p14: board integration_elec_slave.kicad_pcb from below]

Board: 2 copper layers, 100.0 x 100.0 mm, 114 parts (9 on the bottom side), 71 nets.
