zarte13/PI4/code_integration_elec/onboard/Core/Src/main.c

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
/* Includes ------------------------------------------------------------------*/
#include "main.h"
#include "dma.h"
#include "i2c.h"
#include "tim.h"
#include "usart.h"
#include "usb_device.h"
#include "gpio.h"

/* USER CODE BEGIN Includes */
#include "ads1015.h"
#include "XbeeRF.h"
#include "RF_Reception.h"
#include <string.h>
/* USER CODE END Includes */

/* USER CODE BEGIN PD */
#define ADS1015_REG_CONV 0b00000001
/* USER CODE END PD */


void SystemClock_Config(void);
/* USER CODE BEGIN 0 */
static ADS1015_Handle ads;
static float voltage;
static Xbee_message_receive receive_msg;
Xbee_Message send_msg;
volatile static bool new_rf_message = false;
/* USER CODE END 0 */

/**
  * @brief  The application entry point.
  * @retval int
  */
int main(void)
{

  /* MCU Configuration--------------------------------------------------------*/

  /* Reset of all peripherals, Initializes the Flash interface and the Systick. */
  HAL_Init();

  /* Configure the system clock */
  SystemClock_Config();

  /* Initialize all configured peripherals */
  MX_GPIO_Init();
  MX_DMA_Init();
  MX_I2C1_Init();
  MX_USART1_UART_Init();
  MX_TIM2_Init();
  MX_USB_DEVICE_Init();
  MX_TIM1_Init();
  /* USER CODE BEGIN 2 */
  // todo : implémenter les séquences d'initialisation des différents modules
  HAL_TIM_Base_Start_IT(&htim1);
  XBeeRF_Init();
  send_msg.start_char = 0xFEEDCAFE;
  send_msg.end_char = 0xBEEFCACA;

  //XBee_StartReceive();
  //HAL_UART_Receive_IT(&huart1, &temp_byte, 1);

  HAL_GPIO_WritePin(SOLENOID_1_GPIO_Port,SOLENOID_1_Pin,GPIO_PIN_RESET);
  HAL_GPIO_WritePin(SOLENOID_2_GPIO_Port,SOLENOID_2_Pin,GPIO_PIN_RESET);
  /* USER CODE BEGIN 2 */
  ADS1015_Init(&ads, &hi2c1);

  ADS1015_StartConversion(&ads);

  send_msg.start_char = 0xCACAFEED;
  send_msg.end_char = 0xCAFEBEEF;
  /* USER CODE END 2 */

  /* Infinite loop */
  /* USER CODE BEGIN WHILE */
  while (1)
  {
	  GPIO_PinState valve1 = HAL_GPIO_ReadPin(SOLENOID_1_GPIO_Port, SOLENOID_1_Pin);
	  GPIO_PinState valve2 = HAL_GPIO_ReadPin(SOLENOID_2_GPIO_Port, SOLENOID_2_Pin);

	  switch ((valve1 << 1) | valve2)
	  {
	      case 0b00: send_msg.valves = 0;  break;
	      case 0b10: send_msg.valves = 1;  break;
	      case 0b01: send_msg.valves = 2;  break;
	      case 0b11: send_msg.valves = 3;  break;
	  }

	  //HAL_Delay(1000);
	  //printf("miaw\r\n");
	  if (ads.data_ready_flag) {
	      int16_t raw = ADS1015_GetResult(&ads);
	      ADS1015_PrepMsg(raw);
	  }

	  if (new_rf_message){
	      new_rf_message = false;

	      if ((receive_msg.start_receive == 0xFEEDCACA) &&
	          (receive_msg.fin_receive   == 0xBEEFCAFE)){
	    	  printf("caliss:%X",receive_msg.start_receive);

	          HAL_GPIO_WritePin(SOLENOID_1_GPIO_Port, SOLENOID_1_Pin,
	              receive_msg.message_receive_valve1 == 0xFFFFFFFF ? GPIO_PIN_SET : GPIO_PIN_RESET);

	          HAL_GPIO_WritePin(SOLENOID_2_GPIO_Port, SOLENOID_2_Pin,
	              receive_msg.message_receive_valve2 == 0xFFFFFFFF ? GPIO_PIN_SET : GPIO_PIN_RESET);

	          printf("valve1=%lu valve2=%lu\r\n",
	                 receive_msg.message_receive_valve1,
	                 receive_msg.message_receive_valve2);
	      }
	      else {
	          printf("Message invalide\r\n");
	          printf("Start : %X\n\r", receive_msg.start_receive);
	          printf("end : %X\n\r", receive_msg.fin_receive);
	      }
	  }
    /* USER CODE END WHILE */

    /* USER CODE BEGIN 3 */
  }
  /* USER CODE END 3 */
}

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
/* USER CODE BEGIN 4 */
void HAL_GPIO_EXTI_Callback(uint16_t GPIO_Pin) {
    if (GPIO_Pin == INTERRUPT_ADC_Pin) {
        ADS1015_EXTI_Callback(&ads);
    }
}

void HAL_I2C_MemRxCpltCallback(I2C_HandleTypeDef *hi2c) {
    if (hi2c == &hi2c1) {
        ADS1015_DMA_RxComplete(&ads);
    }
}

#include "usbd_cdc_if.h"
int _write(int file, char *ptr, int len)
{
    CDC_Transmit_HS((uint8_t *)ptr, len); // Remplacer HS par FS si nécessaire
    return len;
}

void HAL_UART_RxCpltCallback(UART_HandleTypeDef *huart){
    if (huart->Instance == USART1){
        memcpy(&receive_msg, rx_uart_buffer, sizeof(Xbee_message_receive));
        new_rf_message = true;
        HAL_UART_Receive_IT(&XBEE_RF_UART_HANDLE, rx_uart_buffer, sizeof(Xbee_message_receive));
    }
}

void HAL_TIM_PeriodElapsedCallback(TIM_HandleTypeDef *htim)
{
    if (htim->Instance == TIM1)
    {
    	XBeeRF_Task(); // LED toutes les 500ms
        // ou set un flag :
        // flag_500ms = 1;
    }
}
/* USER CODE END 4 */
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
