zarte13/PI4/code_integration_elec/onboard/integration_elec_slave.ioc

Mcu.UserName=STM32F446RETx
PA10.GPIO_Label=XBEE_UART_OUT
PA10.Signal=USART1_RX
PA13.Signal=SYS_JTMS-SWDIO
PA14.Signal=SYS_JTCK-SWCLK
PA8.GPIO_Label=XBEE_RQ
PA8.Signal=GPIO_Output
PA9.GPIO_Label=XBEE_UART_IN
PA9.Signal=USART1_TX
PB0.GPIO_Label=SOLENOID_1
PB0.Signal=GPIO_Output
PB1.GPIO_Label=SOLENOID_2
PB1.Signal=GPIO_Output
PB13.Signal=USB_OTG_HS_VBUS
PB14.Signal=USB_OTG_HS_DM
PB15.Signal=USB_OTG_HS_DP
PB6.Signal=I2C1_SCL
PB7.Signal=I2C1_SDA
PC0.GPIO_Label=INTERRUPT_ADC
PC0.Signal=GPXTI0
PC10.GPIO_Label=XBEE_N_RESET
PC10.Signal=GPIO_Output
PC4.GPIO_Label=XBEE_LED
PC4.Signal=GPIO_Input
PC9.GPIO_Label=XBEE_STATUS
PC9.Signal=GPIO_Input
PH0-OSC_IN.Signal=RCC_OSC_IN
PH1-OSC_OUT.Signal=RCC_OSC_OUT
