zarte13/PI4/code_integration_elec/onboard/Core/Inc/main.h

#define INTERRUPT_ADC_Pin GPIO_PIN_0
#define INTERRUPT_ADC_GPIO_Port GPIOC
#define INTERRUPT_ADC_EXTI_IRQn EXTI0_IRQn
#define XBEE_LED_Pin GPIO_PIN_4
#define XBEE_LED_GPIO_Port GPIOC
#define SOLENOID_1_Pin GPIO_PIN_0
#define SOLENOID_1_GPIO_Port GPIOB
#define SOLENOID_2_Pin GPIO_PIN_1
#define SOLENOID_2_GPIO_Port GPIOB
#define XBEE_STATUS_Pin GPIO_PIN_9
#define XBEE_STATUS_GPIO_Port GPIOC
#define XBEE_RQ_Pin GPIO_PIN_8
#define XBEE_RQ_GPIO_Port GPIOA
#define XBEE_UART_IN_Pin GPIO_PIN_9
#define XBEE_UART_IN_GPIO_Port GPIOA
#define XBEE_UART_OUT_Pin GPIO_PIN_10
#define XBEE_UART_OUT_GPIO_Port GPIOA
#define XBEE_N_RESET_Pin GPIO_PIN_10
#define XBEE_N_RESET_GPIO_Port GPIOC
