zarte13/PI4/code_integration_elec/onboard/Core/Src/ads1015.c

// Auteur : Émile Mayer
// Date de création 20 mars
// Date de modfication 20 mars
// PI4

#include "ads1015.h"

extern Xbee_Message send_msg;

void ADS1015_Init(ADS1015_Handle *ads, I2C_HandleTypeDef *hi2c) {
    ads->hi2c  = hi2c;
    ads->state = ADS1015_IDLE;

    uint8_t buf[3];
    HAL_StatusTypeDef ret;

    buf[0] = ADS1015_REG_LO_THRESH;
    buf[1] = 0x00; buf[2] = 0x00;
    ret = HAL_I2C_Master_Transmit(ads->hi2c, ADS1015_ADDR, buf, 3, HAL_MAX_DELAY);
    if (ret != HAL_OK) { /* Breakpoint ici — adresse I2C wronge ou bus bloqué */ }

    buf[0] = ADS1015_REG_HI_THRESH;
    buf[1] = 0x80; buf[2] = 0x00;
    ret = HAL_I2C_Master_Transmit(ads->hi2c, ADS1015_ADDR, buf, 3, HAL_MAX_DELAY);
    if (ret != HAL_OK) {
    	int oof = 69;
    	int miaw = 0;
    }
}

void ADS1015_StartConversion(ADS1015_Handle *ads) {
    if (ads->state != ADS1015_IDLE) return;

    uint16_t config = ADS1015_CONFIG_DEFAULT;
    ads->tx_buf[0] = ADS1015_REG_CONFIG;
    ads->tx_buf[1] = (config >> 8) & 0xFF;
    ads->tx_buf[2] = (config)      & 0xFF;

    ads->state = ADS1015_WAITING_CONVERSION;

    HAL_StatusTypeDef ret = HAL_I2C_Master_Transmit(ads->hi2c, ADS1015_ADDR, ads->tx_buf, 3, HAL_MAX_DELAY);
    if (ret != HAL_OK) {
        ads->state = ADS1015_IDLE;  // Breakpoint ici — I2C fail
    }
}

// Appelé depuis HAL_GPIO_EXTI_Callback quand ALERT/RDY tombe bas
void ADS1015_EXTI_Callback(ADS1015_Handle *ads) {
    if (ads->state != ADS1015_WAITING_CONVERSION) return;

    ads->state = ADS1015_READING;

    // Write registre + Read 2 octets — tout en DMA, une seule transaction
    HAL_I2C_Mem_Read_DMA(ads->hi2c,
                          ADS1015_ADDR,
                          ADS1015_REG_CONVERSION,
                          I2C_MEMADD_SIZE_8BIT,
                          ads->rx_buf,
                          2);
}

// Appelé depuis HAL_I2C_MasterRxCpltCallback
void ADS1015_DMA_RxComplete(ADS1015_Handle *ads) {
    if (ads->state != ADS1015_READING) return;

    int16_t raw = ((int16_t)(ads->rx_buf[0] << 8) | ads->rx_buf[1]) >> 4;
    ads->result = raw;

    ads->state = ADS1015_IDLE;
    ADS1015_StartConversion(ads);  // ← relancer ICI, state = WAITING avant que l'EXTI puisse firer

    ads->data_ready_flag = true;   // ← setter le flag EN DERNIER
}

int16_t ADS1015_GetResult(ADS1015_Handle *ads) {
    ads->data_ready_flag = false;     // acquitte seulement le flag
    return ads->result;               // state déjà géré
}

float ADS1015_PrepMsg(int16_t raw) {
    // PGA = ±2.048V → LSB = 1 mV
	float tension = (float)raw * 0.002f*3/2;
	float corrected_tension = tension - 0.5f;
	float pression = corrected_tension/4 * 100;
	send_msg.pression = pression;
    return pression;
}
