zarte13/PI4/(commit log)

2026-01-23 EM - Ajout master PCB
    [integration_elec_master.kicad_pcb, integration_elec_master.kicad_sch]
2026-01-23 EM - Ajout slave PCB
    [integration_elec_slave.kicad_pcb, integration_elec_slave.kicad_sch]
2026-01-23 EM - Ajout de readme pour les folders de footprint/symbols/3dparts
2026-01-23 jte touche
    [integration_elec_master.kicad_pcb, integration_elec_master.kicad_sch]
2026-01-27 EM - Ajout des schématiques XBEE, pas implémenté les footprints encore
    [MCU.kicad_sch, XBEE.kicad_sch, integration_elec_master.kicad_sch, integration_elec_slave.kicad_sch]
2026-01-27 EM - Ajout des pages hiérarchiques pour le slave, next up : Master
    [MCU.kicad_sch, Regulator.kicad_sch, USB_DEBUG.kicad_sch, integration_elec_slave.kicad_sch]
2026-01-27 EM - Ajout des pages hiérarchiques pour le master, next : ajouter connecteurs pour les capteurs
    [DEBUG_USB.kicad_sch, MCU.kicad_sch, REGULATOR.kicad_sch, integration_elec_master.kicad_sch]
2026-02-03 EM - Ajout des contraintes JLCPCB, passé à 4 couches
    [integration_elec_master.kicad_pcb, integration_elec_slave.kicad_pcb]
2026-02-05 Add footprint screen
2026-02-05 Added screen into schematic
    [MCU.kicad_sch, TFT_SCREEN.kicad_sch, integration_elec_master.kicad_sch]
2026-02-06 Added footprint, symbol, 3D model for joystick. Added schematic for Joystick and comments
    [DEBUG_USB.kicad_sch, MCU.kicad_sch, REGULATOR.kicad_sch, TFT_SCREEN AND JOYSTICK.kicad_sch, XBEE.kicad_sch, integration_elec_master.kicad_pcb, integration_elec_master.kicad_sch]
2026-02-06 EM - Avancement du slave et determination ADC pour LTF6800
    [ADC.kicad_sch, CONNECTORS.kicad_sch, MCU.kicad_sch, integration_elec_slave.kicad_sch]
2026-02-06 Added switch in design + Footprint + symbol
    [MCU.kicad_sch, TFT_SCREEN AND JOYSTICK.kicad_sch, integration_elec_master.kicad_pcb]
2026-02-06 Added footprint
2026-02-06 EM - fuck it we merge et on cree deux branches
    [ADC.kicad_sch, CONNECTORS.kicad_sch, MCU.kicad_sch, Regulator.kicad_sch, USB_DEBUG.kicad_sch, XBEE.kicad_sch, integration_elec_slave.kicad_sch]
2026-02-20 EM - Correction des bus
    [ADC.kicad_sch, CONNECTORS.kicad_sch, MCU.kicad_sch, RELAY8_J104D2C12VDC_20S_CRS.step, Regulator.kicad_sch, SMA_DIO.step, USB_DEBUG.kicad_sch, integration_elec_slave.kicad_sch]
2026-02-20 EM - Fini schématique attente de review
    [ADC.kicad_sch, CONNECTORS.kicad_sch, GESTION_ALIM.kicad_sch, MCU.kicad_sch, Regulator.kicad_sch, USB_DEBUG.kicad_sch, XBEE.kicad_sch, integration_elec_slave.kicad_pcb]
2026-02-27 EM - Ajout John Pork et debut schematic
    [ADC.kicad_sch, integration_elec_slave.csv, integration_elec_slave.kicad_pcb]
2026-02-27 EM - Fin du schématique, ajout de diode pour empêcher de backfeeder le USB. Début PCB et ajout carré 100x100
    [Regulator.kicad_sch, integration_elec_slave.kicad_pcb, integration_elec_slave.kicad_sch]
2026-02-28 EM - Avancement du placement du PCB, fini USB et RELAIS, en train de continuer micro et regulateurs
    [integration_elec_slave.kicad_pcb, integration_elec_slave.kicad_sch]
2026-02-28 EM - Ajout du copper zone et chaise musicale pour le micro et le USB
    [integration_elec_slave.kicad_pcb]
2026-02-28 EM - PCB pas mal terminé, on review ça soon
    [integration_elec_slave.kicad_pcb]
2026-02-28 EM - Attente de review, complété avec les 3D
    [GESTION_ALIM.kicad_sch, integration_elec_slave.kicad_pcb]
2026-02-28 EM - Oublié de run le script de via-stitching
    [integration_elec_slave.kicad_pcb]
2026-03-04 EM - Review pas mal finale
    [ADC.kicad_sch, MCU.kicad_sch, integration_elec_slave.kicad_pcb]
2026-03-10 EM - Clean-up avant de commencer le code
    [436500315.stp, 436500415.stp]
2026-03-21 EM - Config du cubemx devrait être finie, début du code pour le ADS1015. Ajout de Todo. Next : finir ADS1015
2026-03-21 EM - Ajout du call back de l'interrupt de l'ADC, ajout de l'init de l'ADC qui sera à confirmer.
2026-03-21 EM - Ajout du callback DMA pour adc, à tester. Ajout du prototypage pour les xbee
2026-03-27 EM - Bin des affaires qui marchent (im losing it)
2026-03-27 EM - USB fonctionne esti que c hot
2026-03-30 EM - Ajout de l'état des valves, code envoyé a kassem
