zarte13/PI4/(notices)

Notices in the files:
code_integration_elec/onboard/Core/Src/main.c:
Copyright (c) 2026 STMicroelectronics.
All rights reserved.
This software is licensed under terms that can be found in the LICENSE file
